RodePioneer/VeloPuter/README.md

# VeloPuter
This repository contains the development of both the Arduino based hardware and the software for a Velomobile board computer.
