RodePioneer/VeloPuter/Documentation/VeloPuter_BillOfMaterials.xlsx

Billl Of Materials
# | Name | Type nr | Amount |  |  |  | URL
1 | PCB | 1.2 | 1 | 3.50 | 3.50 | ~35 EUR per tien | https://www.seeedstudio.com/?gclid=CKn9oMPpzNECFYU-Gwodv90Keg
2 | Arduino | Micro |  | 18.97 | 0.00 | Kloon is goedkoper | http://nl.mouser.com/ProductDetail/Genuino/GBX00053/
3 | Oled Display | SH1106 |  | 16.95 | 0.00 | Zonder garantie: voor de helft op dx.com | https://www.hobbyelectronica.nl/product/128x64-oled-wit-i2c-display-1-3inch/
4 | Stroom regelaar | LDD-700 |  | 4.38 | 0.00 |  | http://nl.mouser.com/Search/ProductDetail.aspx?R=LDD-700Lvirtualkey63430000virtualkey709-LDD-700L
5 | Zoomer | SD160709 | 1 | 2.04 | 2.04 |  | https://nl.mouser.com/Search/ProductDetail.aspx?R=SD160709virtualkey52130000virtualkey810-SD160709
6 | Weerstand | 50 kOhm | 0 | 0.09 | 0.00 |  | http://nl.mouser.com/ProductDetail/Vishay-Dale/CCF0756K0GKE36/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
7 | Weerstand | 100 kOhm | 0 | 0.09 | 0.00 |  | http://nl.mouser.com/ProductDetail/Vishay-Dale/CCF07100KJKE36/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
8 | Weerstand | 1 Ohm | 0 | 0.10 | 0.00 |  | http://nl.mouser.com/ProductDetail/TE-Connectivity-Neohm/RR03J1R2TB/
9 | Weerstand | 1 MOhm | 0 | 0.09 | 0.00 |  | http://nl.mouser.com/ProductDetail/Yageo/MFR-25FBF52-1M/?qs=sGAEpiMZZMu61qfTUdNhG0IXHLFuiNndLutPCQjaM9A%3d
10 | Weerstand | 3 MOhm | 0 | 0.13 | 0.00 |  | http://nl.mouser.com/ProductDetail/Yageo/MFR50SFTE52-3M/?qs=sGAEpiMZZMu61qfTUdNhG0IXHLFuiNnd8Ohx6FKyvoE%3d
11 | Mosfet | B7546 | 2 | 0.79 | 1.58 |  | http://nl.mouser.com/Search/ProductDetail.aspx
12 | 5V regelaar | LM2931 | 1 | 1.00 | 1.00 |  | http://nl.mouser.com/ProductDetail/ON-Semiconductor/LM2931T-50G/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
13 | Condensator | 1mF | 1 | 0.22 | 0.22 |  | http://nl.mouser.com/Search/ProductDetail.aspx
14 | Condensator | 200 uF | 1 | 0.20 | 0.20 |  | http://nl.mouser.com/Search/ProductDetail.aspx
15 | Condensator | 100 nF | 1 | 0.09 | 0.09 |  | http://nl.mouser.com/Search/ProductDetail.aspx
16 | Diode | 1N4148 | 1 | 0.03 | 0.03 |  | http://nl.mouser.com/Search/ProductDetail.aspx?R=1N4148-Tvirtualkey58300000virtualkey583-1N4148-T
17 | Zener diode | 1N5242BTR | 1 | 0.10 | 0.10 |  | http://nl.mouser.com/Search/ProductDetail.aspx?R=1N5242BTRvirtualkey51210000virtualkey512-1N5242BTR
18 | Connector 2P | 2 Pins | 1 | 0.51 | 0.51 | Kan goedkoper maar stekkerbaar is handig | http://nl.mouser.com/Search/ProductDetail.aspx
19 | Plug 2P | 2 Pins | 1 | 0.54 | 0.54 | Kan goedkoper maar stekkerbaar is handig | http://nl.mouser.com/Search/ProductDetail.aspx
20 | Connector 4P | 4 Pins | 1 | 1.03 | 1.03 | Kan goedkoper maar stekkerbaar is handig | http://nl.mouser.com/Search/ProductDetail.aspx
21 | Plug 4P | 4 Pins | 1 | 1.24 | 1.24 | Kan goedkoper maar stekkerbaar is handig | http://nl.mouser.com/Search/ProductDetail.aspx
22 | Connector 6P | 6 Pins | 1 | 1.44 | 1.44 | Kan goedkoper maar stekkerbaar is handig | http://nl.mouser.com/Search/ProductDetail.aspx
23 | plug 6P | 6 Pins | 1 | 1.75 | 1.75 | Kan goedkoper maar stekkerbaar is handig | http://nl.mouser.com/Search/ProductDetail.aspx
24 | Header | 17pins | 1 | 1.91 | 1.91 | Veel te duur hier | http://nl.mouser.com/ProductDetail/3M-Electronic-Solutions-Division/929870-01-17-RB/
25 | Header + plug | 8 Pins | 1 | 0.54 | 0.54 | Per 10 | http://www.dx.com/p/7s-26awg-8-pin-li-ion-battery-balance-charger-plug-w-cable-10-pcs-301992
26 | Header + plug | 4 Pins | 1 | 0.25 | 0.25 | Per 10 | http://www.dx.com/p/10-x-11-1v-3s1p-jst-xh-connector-adapter-plugs-for-rc-lipo-battery-balance-charger-10-pcs-245231
27 | Header + plug | 3 Pins | 2 | 0.24 | 0.48 | Per 10 | http://www.dx.com/p/10-x-7-4v-2s1p-jst-xh-connector-adapter-plug-rc-lipo-battery-balance-charger-b6-250087
Totaal |  |  |  |  | 18.45
 |  |  | 1
 |  |  | 1
 |  |  | 1
 |  |  | 5
 |  |  | 1
 |  |  | 5
 |  |  | 1
 |  |  | 1
 |  |  | 1
 |  |  | 1
 |  |  | 2
 |  |  | 1
 |  |  | 1
 |  |  | 1
 |  |  | 1
 |  |  | 1
 |  |  | 1
 |  |  | 1
 |  |  | 1
 |  |  | 1
 |  |  | 1
 |  |  | 1
 |  |  | 1
 |  |  | 2
 |  |  | 1
 |  |  | 1
 |  |  | 2
