RodePioneer/VeloPuter/Eagle/VeloPuter/VeloPuter.brd

## EAGLE design Eagle/VeloPuter/VeloPuter.brd (2020-02-01)

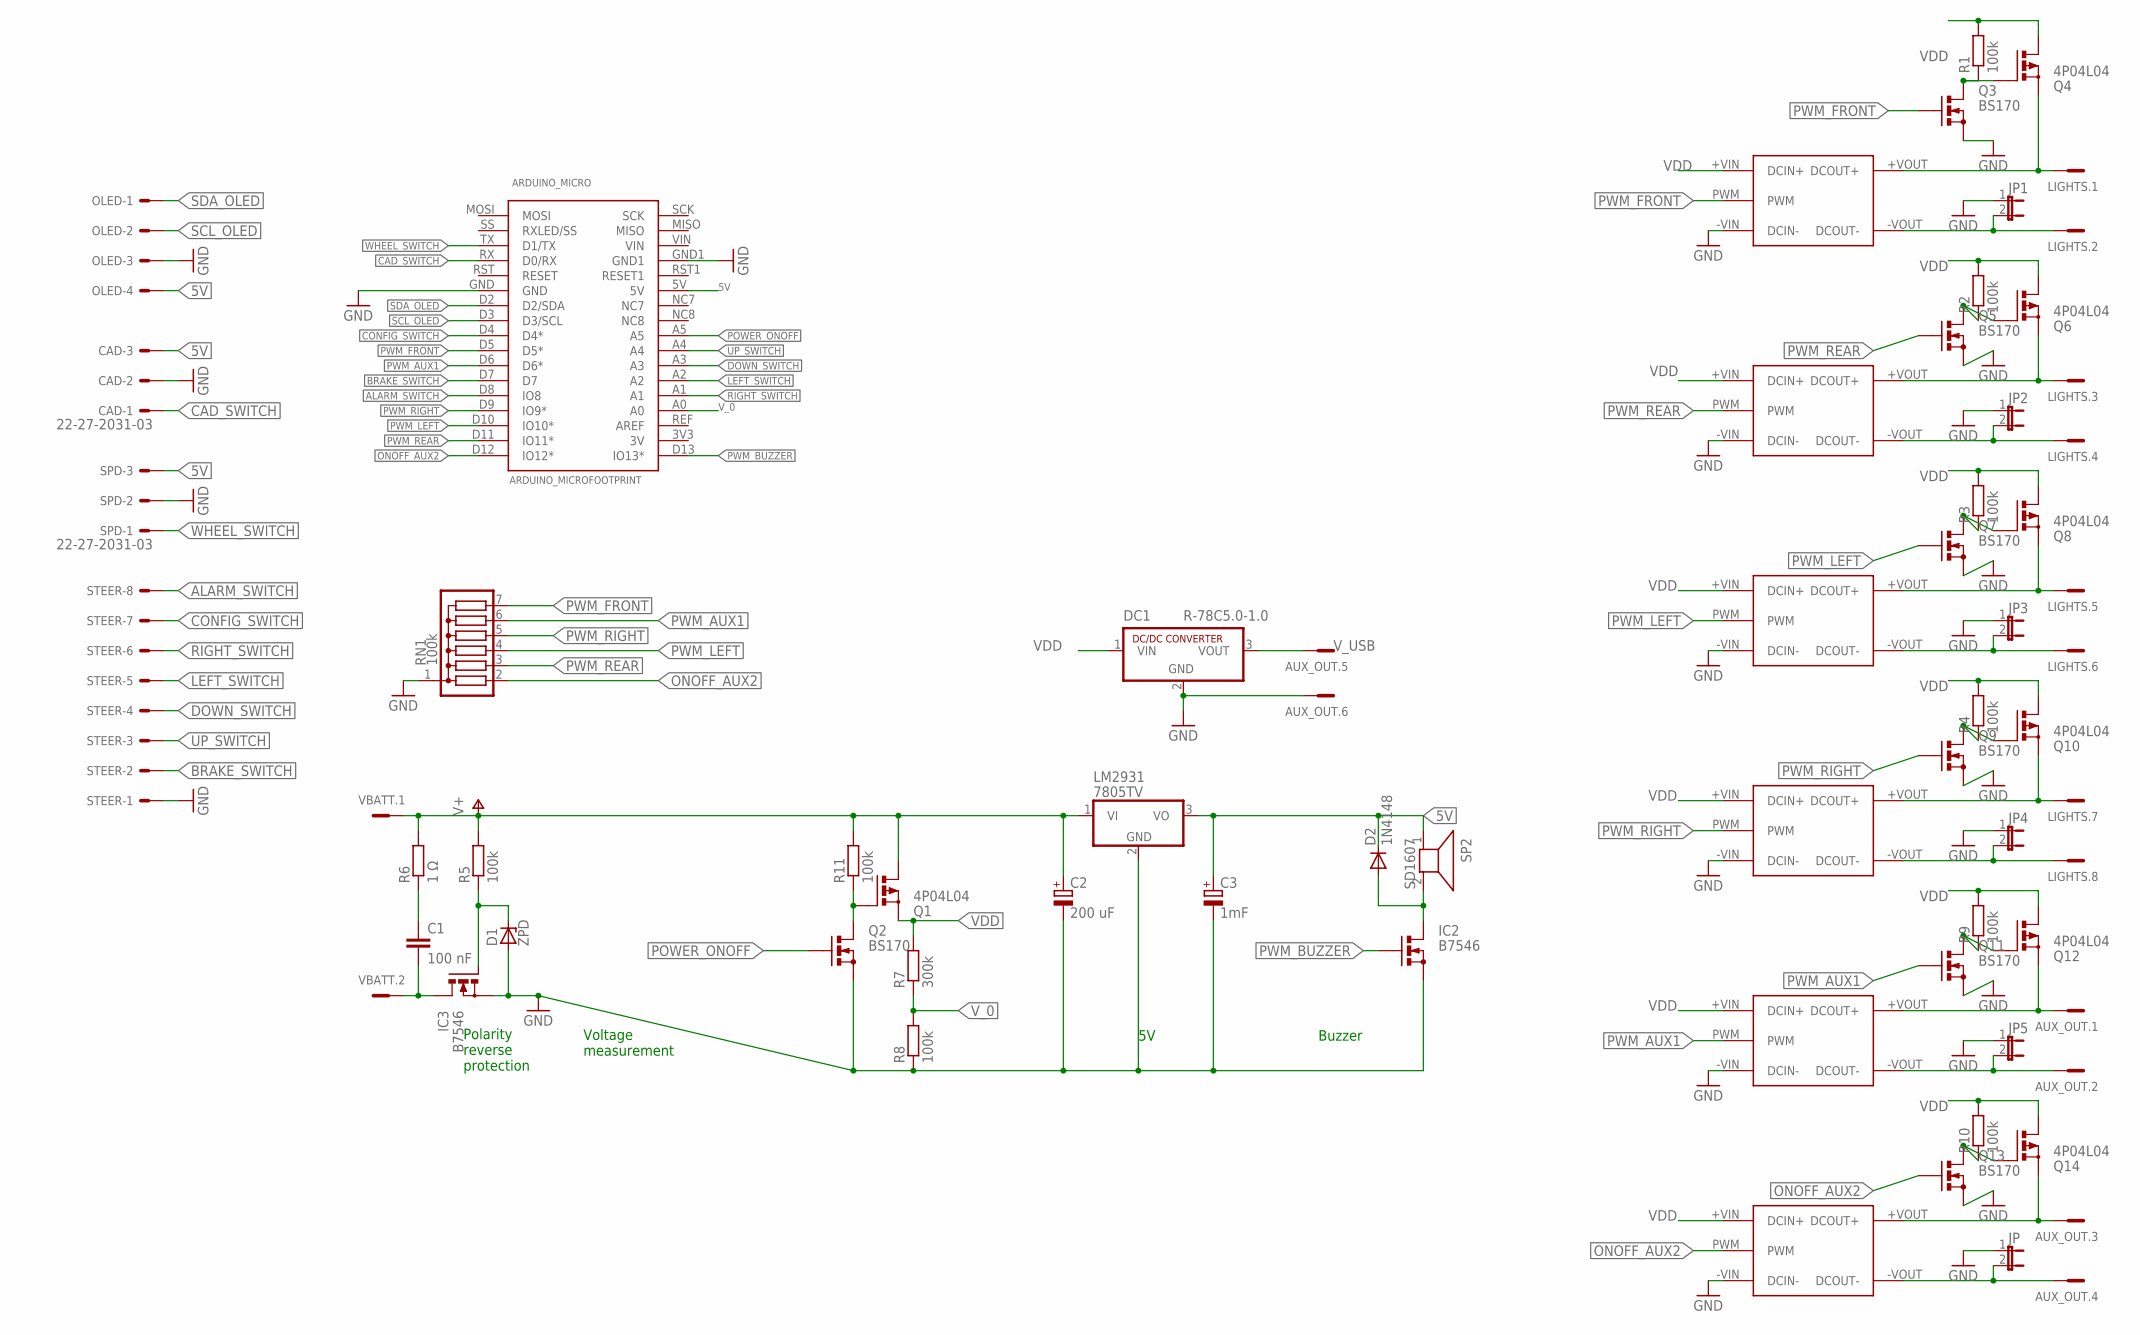
[picture p1: schematic VeloPuter.sch]

Parts:
ARDUINO_MICRO: ARDUINO_MICROFOOTPRINT; ARDUINO-MICRO
AUX_OUT: Aux; MCV6
BRAKE: LDD-L
C1: 100 nF; C2.5-3
C2: 200 uF; E5-10,5
C3: 1mF; E5-10,5
CAD: 22-27-2031-03; 6410-03
D1: ZPD; DO35Z10
D2: 1N4148; DO35-7
DC1: R-78C5.0-1.0; SIP3
IC2: B7546; SOT54E
IC3: B7546; TO220BV
JP, JP1, JP2, JP3, JP4, JP5: JP1
LIGHTS: Lights; MCV8
LM2931: 7805TV; TO220V
OLED: 22-27-2041-04; 6410-04
Q1, Q4, Q6, Q8, Q10, Q12, Q14: 4P04L04; TO220BV
Q2, Q3, Q5, Q7, Q9, Q11, Q13: BS170; SOT54E
R1, R2, R3, R4, R5, R8, R9, R10, R11: 100k; 0207/10
R6: 1 Ω; 0207/10
R7: 300k; 0207/10
RN1: 100k; SIL7
SP2: SD1607; AL60P
SPD: 22-27-2031-03; 6410-03
STEER: 22-27-2081-08; 6410-08
U$1, U$2, U$3, U$4, U$5: LDD-L
VBATT: MCV2

Connections:
5V: ARDUINO_MICRO.5V, C3.+, CAD.3, D2.C, LM2931.3 (VO), OLED.4, SP2.1, SPD.3
ALARM_SWITCH: ARDUINO_MICRO.D8 (IO8), STEER.8
AUX1+: AUX_OUT.1, Q12.S, U$5.+VOUT (DCOUT+)
AUX1-: AUX_OUT.2, JP5.2, U$5.-VOUT (DCOUT-)
AUX2+: AUX_OUT.3, Q14.S, U$1.+VOUT (DCOUT+)
AUX2-: AUX_OUT.4, JP.2, U$1.-VOUT (DCOUT-)
BRAKE_SWITCH: ARDUINO_MICRO.D7, STEER.2
CAD_SWITCH: ARDUINO_MICRO.RX (D0/RX), CAD.1
CONFIG_SWITCH: ARDUINO_MICRO.D4 (D4*), STEER.7
DOWN_SWITCH: ARDUINO_MICRO.A3, STEER.4
FRONT+: LIGHTS.1, Q4.S, U$4.+VOUT (DCOUT+)
FRONT-: JP1.2, LIGHTS.2, U$4.-VOUT (DCOUT-)
GND: ARDUINO_MICRO.GND, ARDUINO_MICRO.GND1, AUX_OUT.6, BRAKE.-VIN (DCIN-), C2.-, C3.-, CAD.2, D1.A, DC1.2 (GND), IC2.S, IC3.S, JP.1, JP1.1, JP2.1, JP3.1, JP4.1, JP5.1, LM2931.2 (GND), OLED.3, Q2.S, Q3.S, Q5.S, Q7.S, Q9.S, Q11.S, Q13.S, R8.1, RN1.1, SPD.2, STEER.1, U$1.-VIN (DCIN-), U$2.-VIN (DCIN-), U$3.-VIN (DCIN-), U$4.-VIN (DCIN-), U$5.-VIN (DCIN-)
LEFT+: LIGHTS.5, Q8.S, U$2.+VOUT (DCOUT+)
LEFT-: JP3.2, LIGHTS.6, U$2.-VOUT (DCOUT-)
LEFT_SWITCH: ARDUINO_MICRO.A2, STEER.5
unnamed: C1.1, R6.1
unnamed: D1.C, IC3.G, R5.1
unnamed: D2.A, IC2.D, SP2.2
unnamed: Q1.G, Q2.D, R11.1
unnamed: Q3.D, Q4.G, R1.1
unnamed: Q5.D, Q6.G, R2.1
unnamed: Q7.D, Q8.G, R3.1
unnamed: Q9.D, Q10.G, R4.1
unnamed: Q11.D, Q12.G, R9.1
unnamed: Q13.D, Q14.G, R10.1
ONOFF_AUX2: ARDUINO_MICRO.D12 (IO12*), Q13.G, RN1.2, U$1.PWM
POWER_ONOFF: ARDUINO_MICRO.A5, Q2.G
PWM_AUX1: ARDUINO_MICRO.D6 (D6*), Q11.G, RN1.6, U$5.PWM
PWM_BUZZER: ARDUINO_MICRO.D13 (IO13*), IC2.G
PWM_FRONT: ARDUINO_MICRO.D5 (D5*), Q3.G, RN1.7, U$4.PWM
PWM_LEFT: ARDUINO_MICRO.D10 (IO10*), Q7.G, RN1.4, U$2.PWM
PWM_REAR: ARDUINO_MICRO.D11 (IO11*), BRAKE.PWM, Q5.G, RN1.3
PWM_RIGHT: ARDUINO_MICRO.D9 (IO9*), Q9.G, RN1.5, U$3.PWM
REAR+: BRAKE.+VOUT (DCOUT+), LIGHTS.3, Q6.S
REAR-: BRAKE.-VOUT (DCOUT-), JP2.2, LIGHTS.4
RIGHT+: LIGHTS.7, Q10.S, U$3.+VOUT (DCOUT+)
RIGHT-: JP4.2, LIGHTS.8, U$3.-VOUT (DCOUT-)
RIGHT_SWITCH: ARDUINO_MICRO.A1, STEER.6
SCL_OLED: ARDUINO_MICRO.D3 (D3/SCL), OLED.2
SDA_OLED: ARDUINO_MICRO.D2 (D2/SDA), OLED.1
UP_SWITCH: ARDUINO_MICRO.A4, STEER.3
V+: C2.+, LM2931.1 (VI), Q1.D, R5.2, R6.2, R11.2, VBATT.1
V-: C1.2, IC3.D, VBATT.2
VDD: BRAKE.+VIN (DCIN+), DC1.1 (VIN), Q1.S, Q4.D, Q6.D, Q8.D, Q10.D, Q12.D, Q14.D, R1.2, R2.2, R3.2, R4.2, R7.2, R9.2, R10.2, U$1.+VIN (DCIN+), U$2.+VIN (DCIN+), U$3.+VIN (DCIN+), U$4.+VIN (DCIN+), U$5.+VIN (DCIN+)
V_0: ARDUINO_MICRO.A0, R7.1, R8.2
V_USB: AUX_OUT.5, DC1.3 (VOUT)
WHEEL_SWITCH: ARDUINO_MICRO.TX (D1/TX), SPD.1

Notes on the sheet:
Polarity reverse protection
Voltage measurement
Buzzer

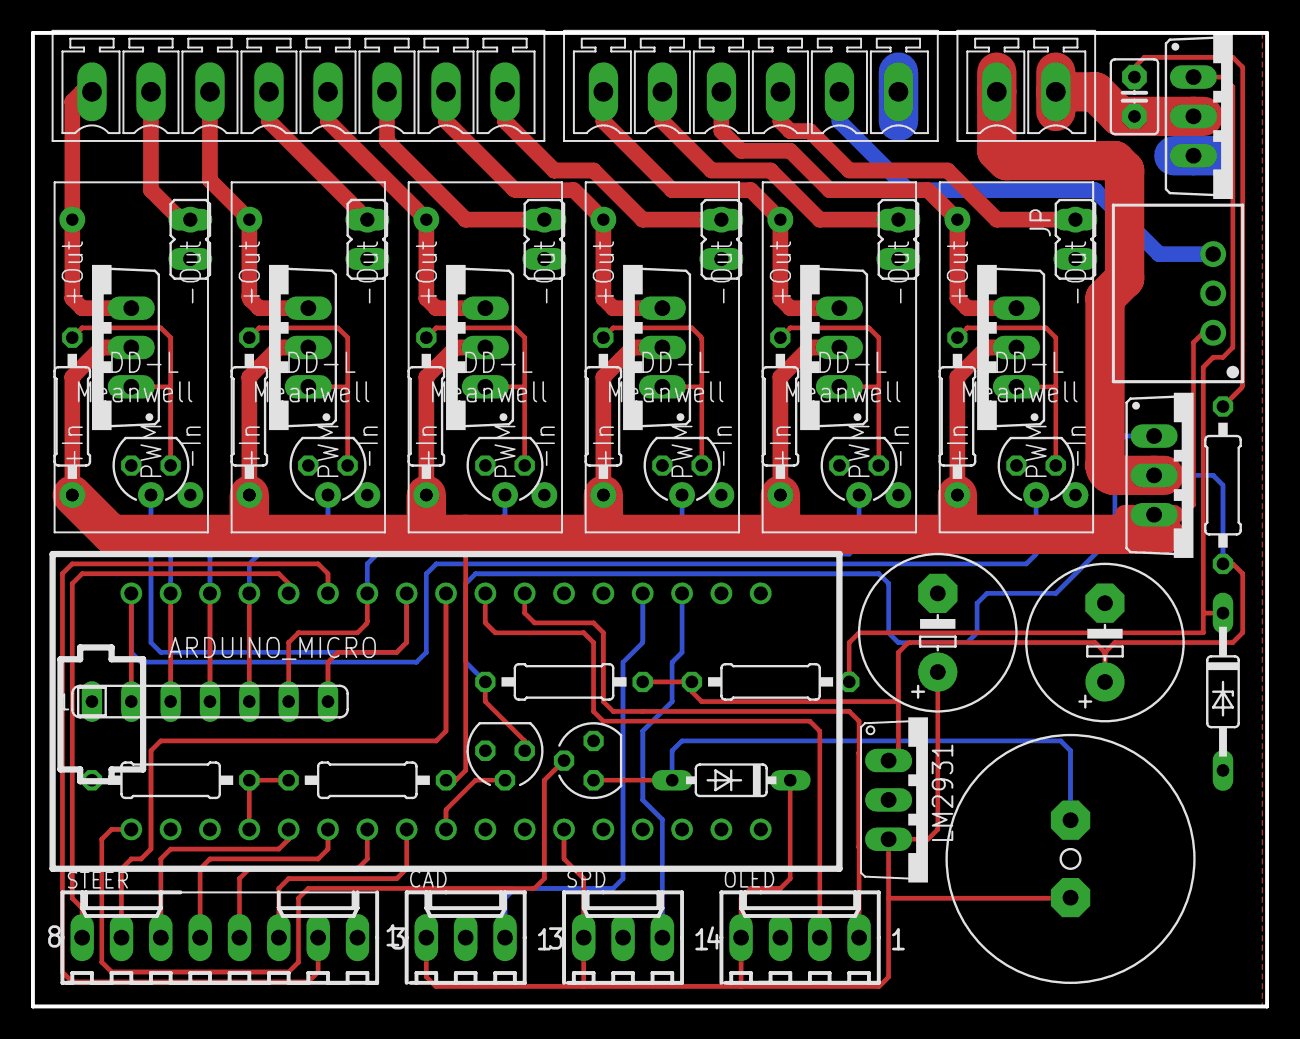
[picture p2: board VeloPuter.brd from above]

Board: 2 copper layers, 79.7 x 62.9 mm, 56 parts (0 on the bottom side), 48 nets.
