RodePioneer/VeloPuter/Arduino/VeloPuter/Draw_Icons.cpp

/*

  Graphics such as the icons on the display.

*/
#include <Arduino.h>
#include <U8glib.h>

const uint8_t icoHighBeam[] U8G_PROGMEM = {
  B00000011, B11111100, B11111111,
  B00000111, B11111100, B11111111,
  B00011110, B00001110, B00000000,
  B00111000, B00000110, B00000000,
  B01110000, B00000110, B01111111,
  B01100000, B00000110, B01111111,
  B01100000, B00000110, B00000000,
  B01100000, B00000110, B00000000,
  B01100000, B00000110, B01111111,
  B01110000, B00000110, B01111111,
  B00111000, B00000110, B00000000,
  B00011110, B00001100, B00000000,
  B00000111, B11111100, B11111111,
  B00000011, B11111100, B11111111
};

//const uint8_t icoMaxBeam[] U8G_PROGMEM = {
//B00000011, B11111100, B11111111,
//B00000111, B11111100, B11111111,
//B00011110, B00001110, B00000000,
//B00111000, B00000110, B00000000,
//B01110000, B00000110, B01111111,
//B01100001, B11000110, B01111111,
//B01100011, B11000110, B00000000,
//B01100011, B11000110, B00000000,
//B01100001, B11000110, B01111111,
//B01110000, B00000110, B01111111,
//B00111000, B00000110, B00000000,
//B00011110, B00001100, B00000000,
//B00001111, B11111100, B11111111,
//B00000011, B11111100, B11111111 };

//const uint8_t icoHighBeam2[] U8G_PROGMEM = {
//B00000011, B11111100, B11111111,
//B00000111, B11111100, B11111111,
//B00011110, B00001110, B00000000,
//B00111000, B11100110, B00000000,
//B01110011, B10110110, B01111111,
//B01101110, B00010110, B01111111,
//B01101000, B11010110, B00000000,
//B01101000, B11010110, B00000000,
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
//B00000000, B00000000, B00000000, B01111110, B00100010, B00100010, B01000100, B00001111, B11000100, B10001001, B00010010, B00100100, B01001000, B00000000, B00000000, B00000000,
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
