RodePioneer/VeloPuter/Arduino/VeloPuter/Led.cpp

/*

  A class per Led. Perhaps we should extent it to leds in general?

*/
#include <Arduino.h>
//#include <TimerOne.h>

class Led
{
    //private:
  private:
    volatile byte ledIntensity = lowIntensity;
    volatile byte flashOn = false;
    volatile long tLastStateChange_ms = 0;
    byte pin;

  public:
    byte offIntensity = 0; // "group" intensity
    byte lowIntensity = 0; // "group" intensity
    byte mediumIntensity = 0; // "normal day ride"
    byte highIntensity = 0; // "normal night ride"
    byte maxIntensity = 0; // "max"

    void setLedIntensity (byte newIntensity) // directly set the new LED value, either digital or analog.
    {
      ledIntensity = newIntensity;
      flashOn = true;
      analogWrite(pin, ledIntensity);
      tLastStateChange_ms = millis();
    }

    byte getLedIntensity () // return the current intensity of the led.
    {
      return ledIntensity;
    }
    
    byte getFlashOnStatus()
    {
      return flashOn;
    }
    
    void toggleFlashLed() // set led intensity to max intensity, without changing internal led intensity (for easy reset)
    {
      if (flashOn)
      {
        analogWrite(pin, ledIntensity);
        flashOn = false;
        tLastStateChange_ms = millis();
      }
      else
      {
        analogWrite(pin, maxIntensity);
        flashOn = true;
        tLastStateChange_ms = millis();
      }  
    }
        
    long getTimeLastChange_ms (void)
    {
      return tLastStateChange_ms;
    }

    void setPin (byte Pin)
    {
      pin = Pin;
    }

    byte getPin ()
    {
      return pin;
    }

    void setLedOff (void)
    {
      ledIntensity = offIntensity;
      setLedIntensity(ledIntensity);
    }

    void setLedLow (void) // switch to high / max
    {
      ledIntensity = lowIntensity;
      setLedIntensity(ledIntensity);
    }

    void setLedMedium (void) // switch to low / min
    {
      ledIntensity = mediumIntensity;
      setLedIntensity(ledIntensity);
    }

    void setLedHigh (void) // switch to high / max
    {
      ledIntensity = highIntensity;
      setLedIntensity(ledIntensity);
    }

    void setLedMax (void) // switch to high / max
    {
      ledIntensity = maxIntensity;
      setLedIntensity(ledIntensity);
    }

    void upLed (void) // increase the intensity
    {
      if      (ledIntensity == offIntensity) setLedLow();
      else if (ledIntensity == lowIntensity) setLedMedium();
      else if (ledIntensity == mediumIntensity) setLedHigh();
      else if (ledIntensity == highIntensity) setLedMax();
    }

    void downLed (void) // lower the intensity
    {
      if      (ledIntensity == lowIntensity) setLedOff();
      else if (ledIntensity == mediumIntensity) setLedLow();
      else if (ledIntensity == highIntensity) setLedMedium();
      else if (ledIntensity == maxIntensity) setLedHigh();
    }
};
