RodePioneer/VeloPuter/(commit log)

2016-01-25 Initial commit of the project until now. This includes a functionional -though not complete- arduino sketch and eagle PCB-design files.
    Arduini libraries are not included.
    [VeloPuter.brd, VeloPuter.sch]
2016-01-25 Partial redesign due to insights from the first builds - VDD of the oled now goes to the 5V not Vbatt. - Larger capacitor for C2. - LM2931 replaced by a TO220 (need new layout for this) - Brake handl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
    [VeloPuter.brd, VeloPuter.sch]
2016-01-30 Added pulldown resistors for the LDD700 PWM inputs. Without these resistors the LED's would flash brightly before the arduino kicks in.
    [VeloPuter.brd, VeloPuter.sch]
2016-02-08 Switched spd and cad pins. Switched switchHeadUpPin and switchHeadDownPin Reduced the number of blinks to 7 Added splash screen Updated the LED intensity of the low setting for the head light 8->16 U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
    [Draw.ino, Update.ino, VeloPuter.ino]
2016-02-13 Updated the display of the battery voltage: it now shows the cell voltage for one cell and estimates of we have 2,3 or 4 cells on board.
    The wheel and cadence sensors are bedounced differently.
2016-02-15 Development backup: - implemented a timed interupt. - sleep mode updates
    seems still a little bit buggy....
    [Draw.ino, Led.cpp, Switch.cpp, Update.ino, VeloPuter.ino]
2016-05-11 new board layout
    has to be checked. Pin changes NOT documented
    [VeloPuter.brd, VeloPuter.sch]
2016-06-21 Version of the Veloputer PCB as made as version 1.2 (number of the PCB).
    This version is uploaded to seeedstudio.com on 2016-02-21.
    [VeloPuter.brd, VeloPuter.sch]
2017-01-07 Code to go with the PCB version 1.2. Suitable for Strada.
2017-01-17 Bugfix: blinkers could stay on during operation.
    [Constants.h, Draw.ino, Draw_Icons.cpp, Led.cpp, Setup.ino, Switch.cpp, Update.ino, VeloPuter.ino]
2017-01-18 Bill of Materials added
    [VeloPuter_BillOfMaterials.xlsx]
2017-03-21 Updates. Added brake light, config for oled intesity and alarmlights button
2017-03-27 Got rid of Timer1. Changed the implementation of the draw routine. It now runs directly from the loop.
2017-05-31 Updates: option to disable battery management. Also: estimation of the current gear (does not yet include multple chainrings / slumpf up front
    [VeloPuter_BillOfMaterials.xlsx]
2017-10-01 Add preprocessor constant for DF
    Change default cassette gear string to "-" (might be in numeric font)
    Rear gear display needed a scaling with the ration of front and read
    wheel sizes
    Add correct wheel sizes for DF
    [Constants.h, Draw.ino, Setup.ino, Update.ino, VeloPuter.ino]
2017-10-02 Correct ratio for gear calculation Set aux led to 0 for all intensities in ICB_DF (not connected).
    [Constants.h]
2017-10-02 Updates to aux led for ICB_DF and gears to byte to save memory
2017-11-30 Use integer values, avoid divisions and round as needed.
    [Update.ino, VeloPuter.ino]
2017-11-30 Simplify battery voltage to percentage conversion.
2017-12-20 Lots of changes: - Switched battery management back to LiPo. This has to be updated soon. - setTeethOnCassette is back to float. This is in order to handle the Slumpf better. Now printing the rounded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
2018-01-04 Started working on the PCB again. Adding swtichoff of the ALL Ldd's. Also: adding a 6th LDDd.
    [VeloPuter.brd, VeloPuter.sch]
2018-01-08 - Added alternative components for the LDDs to be placed at the same positions - Added 5V USB - Added overall Power off - Added 6th LDD/switch (was 5) -> possible also for buzzer. Note that a key for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
    [VeloPuter.brd, VeloPuter.sch]
2018-01-09 Finished placing the components. Next: routing the connections.
    [VeloPuter.brd, VeloPuter.sch]
2018-01-11 Routing done. Next: tripple check everything (such as pinning, lost connections, spacings, design rules etc, etc
    [VeloPuter.brd, VeloPuter.sch]
2018-01-18 Allow selection of battery-type via precompiler constant.
2018-01-20 Make sure that updateBattery() function uses global variable. Otherwise the display will always show 4.20 V.
2018-01-20 Minor layout change
    [VeloPuter.brd, VeloPuter.sch]
2018-05-12 Fix for interference between timeout of brake light and rear light intensity.
    [Update.ino]
2018-08-26 Updated the voltage/capacity table for LiFePO4 batteries.
2019-08-13 Added brakelight timeout. Stops after configured time and also stopns when the bike stopped
    [VeloPuter_BillOfMaterials.xlsx]
2019-08-16 Made aux flash during fog-rear light conditions specific to QuattroVelo only.
    DF and other three-wheelers don't have an AUX light.
2020-01-02 Add flash to fog-setting of rear LED.
    Adds logic to LED class, and uses it from update. Only for ICB_DF, but other
    flashes may benefit as well.
2020-02-01 Board updates
    [VeloPuter.brd, VeloPuter.sch]
